Ultameciia/Tool-Aware-NFC-Reader/Pictures/ToolSelection.jpg

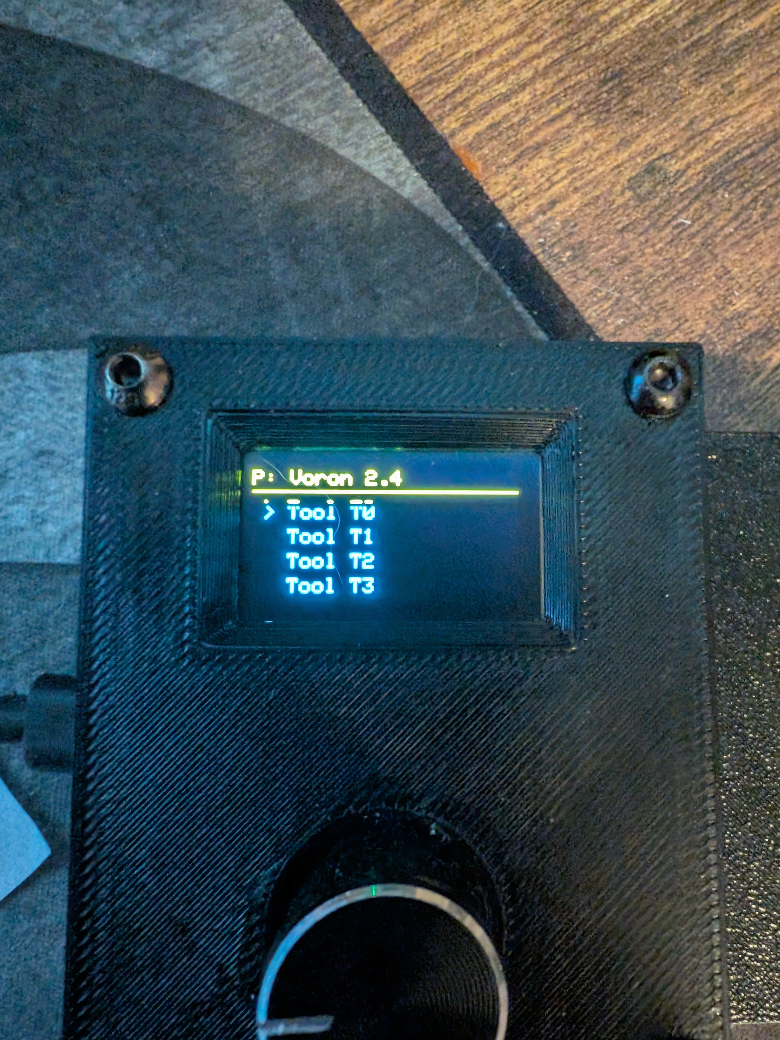
Pictures/ToolSelection.jpg
