Ultameciia/Tool-Aware-NFC-Reader/Pictures/Device.jpg

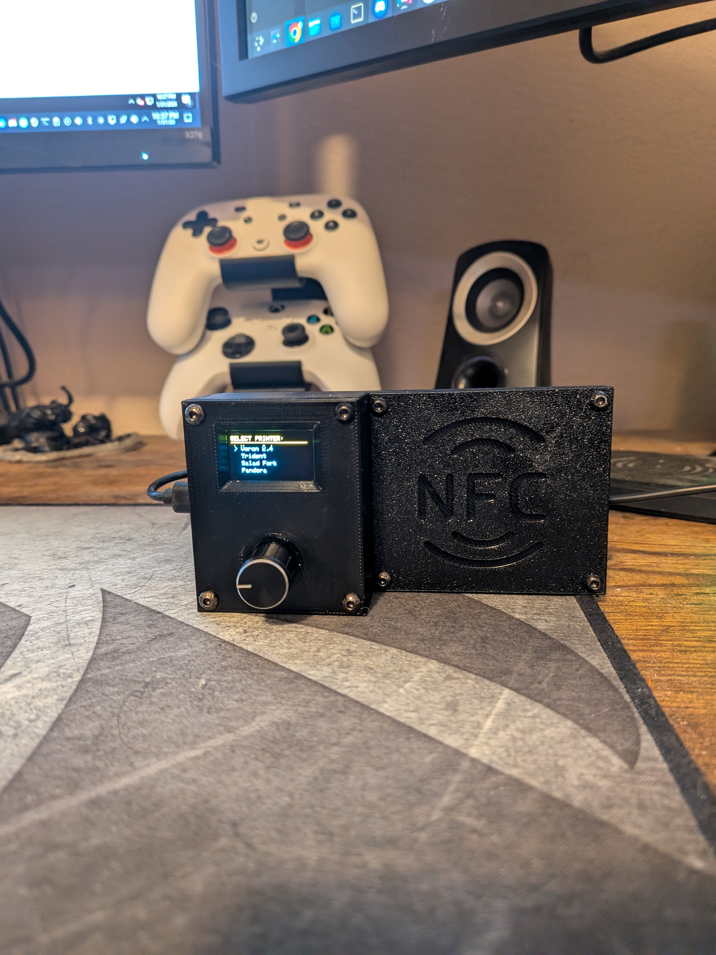
Pictures/Device.jpg
