Ultameciia/Tool-Aware-NFC-Reader/Pictures/mainscreen.jpg

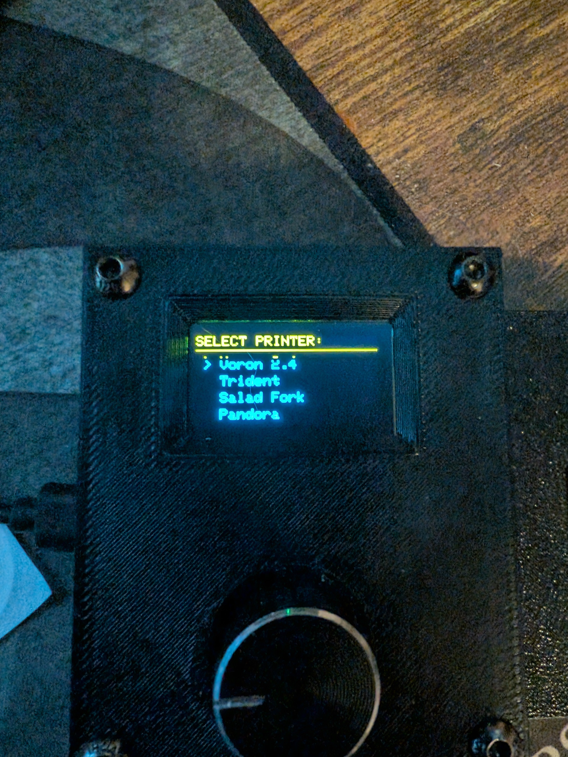
Pictures/mainscreen.jpg
