Ultameciia/Tool-Aware-NFC-Reader/Enclosure/NFC Lid.step

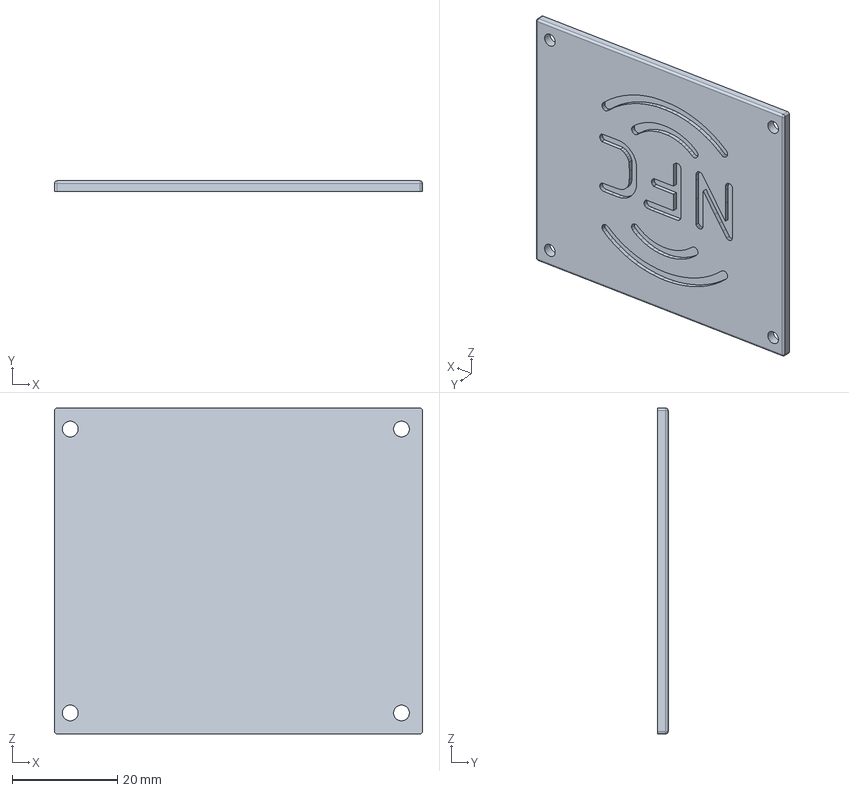
[picture p4: CAD file, 2026-02-01]
Enclosure/NFC Lid.step
70.0 x 2.00 x 62.0 mm
