Ultameciia/Tool-Aware-NFC-Reader/Enclosure/Enclosure V1.2.step

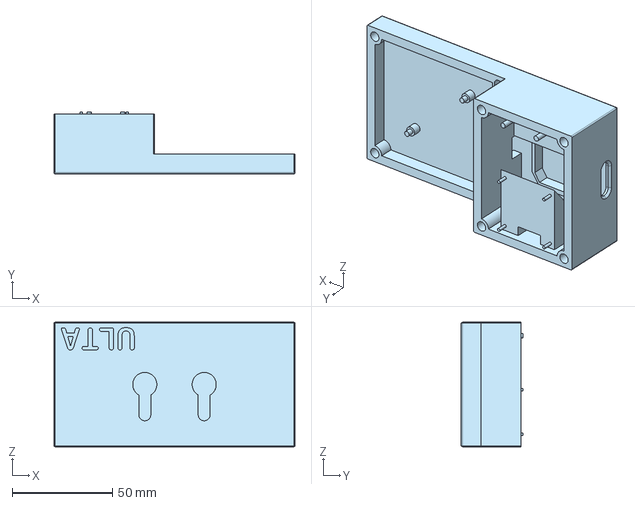
[picture p5: CAD file, 2026-02-01]
Enclosure/Enclosure V1.2.step
120.0 x 30.9 x 62.0 mm
