Ultameciia/Tool-Aware-NFC-Reader/Enclosure/Electronics Lid V1.1.step

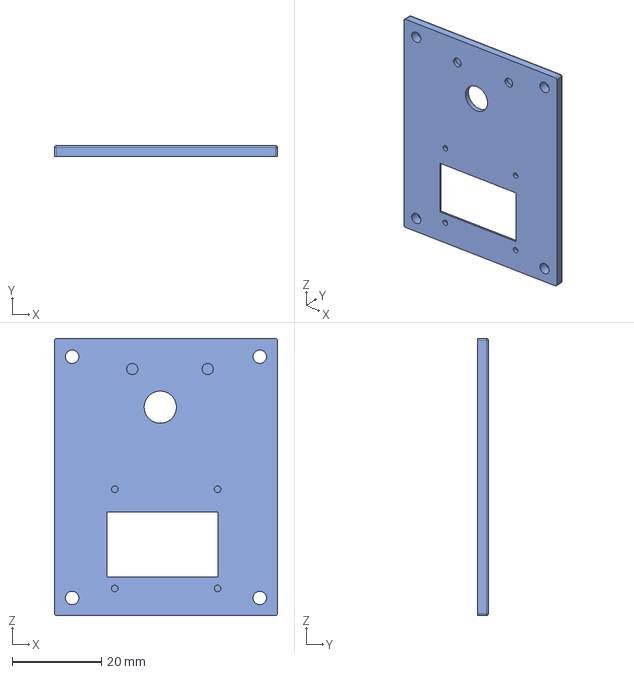
[picture p6: CAD file, 2026-02-01]
Enclosure/Electronics Lid V1.1.step
50.0 x 2.50 x 62.0 mm
